Dirt-Bag-Lab-Supplies/dirtbag_switch_box/README.md

# dirtbag_switch_box
RV Electrical Systems
