Dirt-Bag-Lab-Supplies/dirtbag_switch_box/hardware/hardware_calcs.ods

Sheet: Sheet1
Under voltage | 10
Over voltage | 15
Continuous Current | 5.5A
2ms Blanking Time
Cout | 30uF
Output Rise Time | 20 | ms
Current Max | 6 | A
Blanking Time | 2.8 | ms
R1 | 470000
R2 | 39000
R3 | 43000
R2+R3 | e
R2+R3-R2 | #VALUE!
Under voltage
Vuvlo(rising) | 1.2 | V
Vuv | 8.07804878048781
Vuv_test | #VALUE!
Over voltage
Vovlo | 1.2
Vov | 15.4046511627907
Vov_test | #VALUE!
DVDT
Slew Rate | 0.6 | v/ms
Cdvdt | 3333.33333333333 | pF
I limit
Rlim | 555.666666666667 | ohms
Overcurrent Blanking
Ctimer | 3.33774834437086 | nF

Sheet: 5V_Supply
LM22680
https://www.ti.com/lit/ds/symlink/lm22680.pdf?HQS=dis-dk-null-digikeymode-dsf-pf-null-wwe&ts=1633503149819
Vin Max | 15 | V
Vin Min | 7 | V
Vin Test | 42 | V
Vout | 3.3 | V
Iout Max | 2 | A
Iout Min | 0.1 | A
I_test | 2 | A
Fsw | 500 | kHz
Inductor Selection: 8.2.1.2.1
L | (Vin – Vout) * Vout / (0.3 * Iout * Fsw * Vin)
 | 0.010135714285714
Selected L | 0.012 | H
Ripple Current | (Vin – Vout) * Vout /(L * Fsw * Vin)
 | 0.506785714285714
Peak Current | 2.25339285714286
