Dirt-Bag-Lab-Supplies/dirtbag_switch_box/hardware/12v_switch/cad/switchbox_v1.step

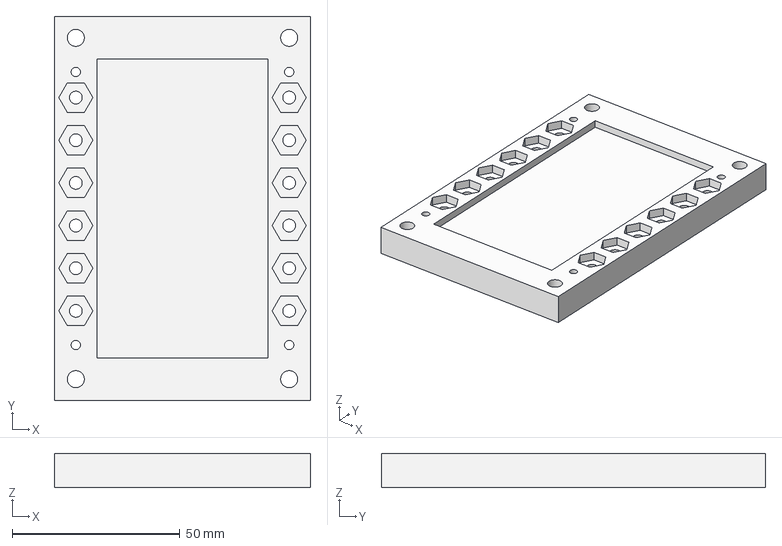
[picture p1: CAD file, 2021-12-15]
hardware/12v_switch/cad/switchbox_v1.step
76.2 x 114.3 x 10.2 mm
LCS_1
