Dirt-Bag-Lab-Supplies/dirtbag_switch_box/hardware/12v_switch/cad/12v_switch_v1.FCStd

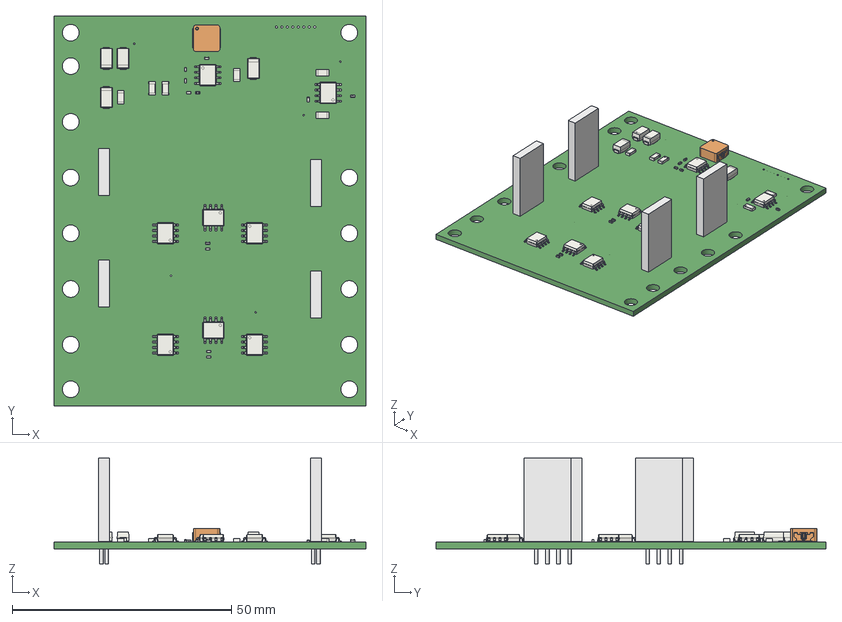
[picture p2: CAD file, 2021-12-15]
hardware/12v_switch/cad/12v_switch_v1.FCStd
71.1 x 88.9 x 24.1 mm
