Dirt-Bag-Lab-Supplies/dirtbag_switch_box/hardware/12v_switch/cad/Nut_Hex_6-32_90480A007.FCStd

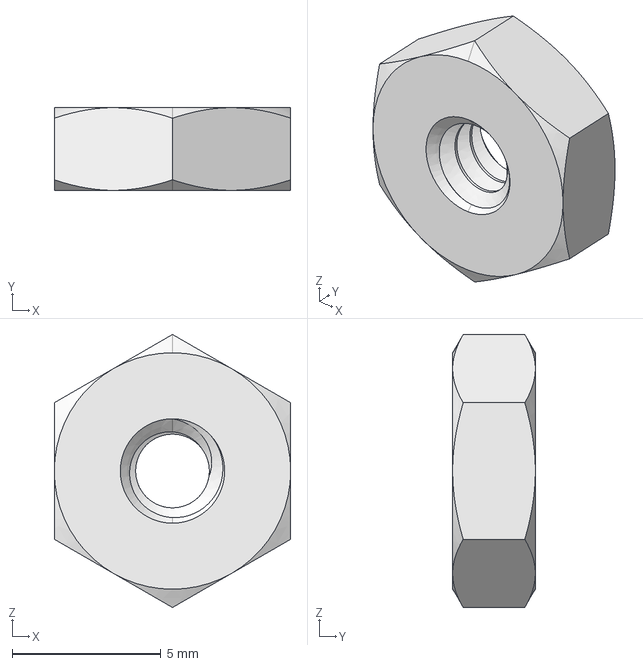
[picture p3: CAD file, 2021-12-15]
hardware/12v_switch/cad/Nut_Hex_6-32_90480A007.FCStd
7.94 x 2.78 x 9.17 mm
