Dirt-Bag-Lab-Supplies/dirtbag_switch_box/(list of files, cad)

Other CAD files:
hardware/12v_switch/cad/12V_switch_Assem.FCStd
hardware/12v_switch/cad/switchbox_v1.FCStd
hardware/12v_switch/cad/switchbox_v1.stl
