Dirt-Bag-Lab-Supplies/dirtbag_switch_box/hardware/12v_switch/cad/12v_switch_pcb.pdf

2.80 "

0.15 "

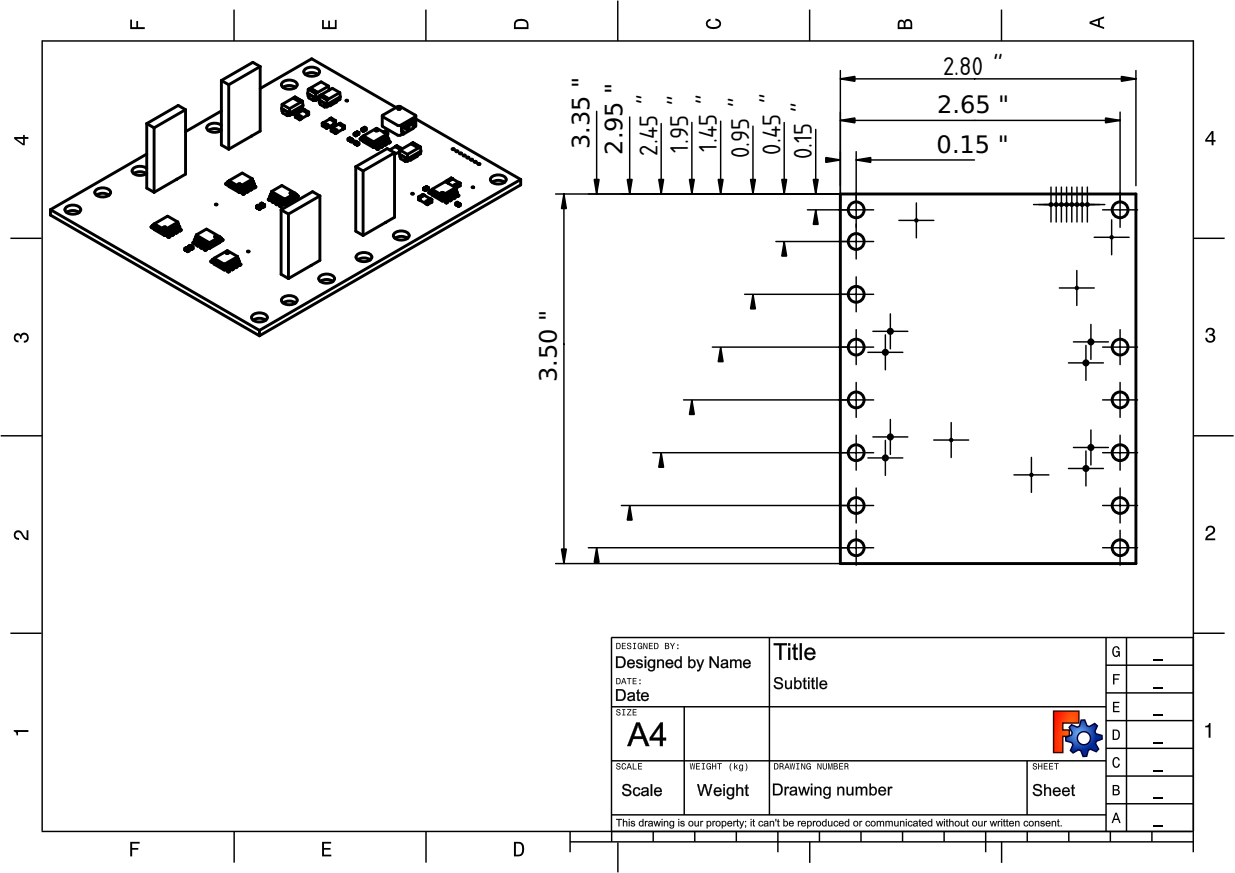
[picture p4: page 1]
