Dirt-Bag-Lab-Supplies/dirtbag_switch_box/hardware/12v_switch/12v_switch.kicad_pcb

## KiCad design hardware/12v_switch/12v_switch.kicad_pcb (2021-12-15)

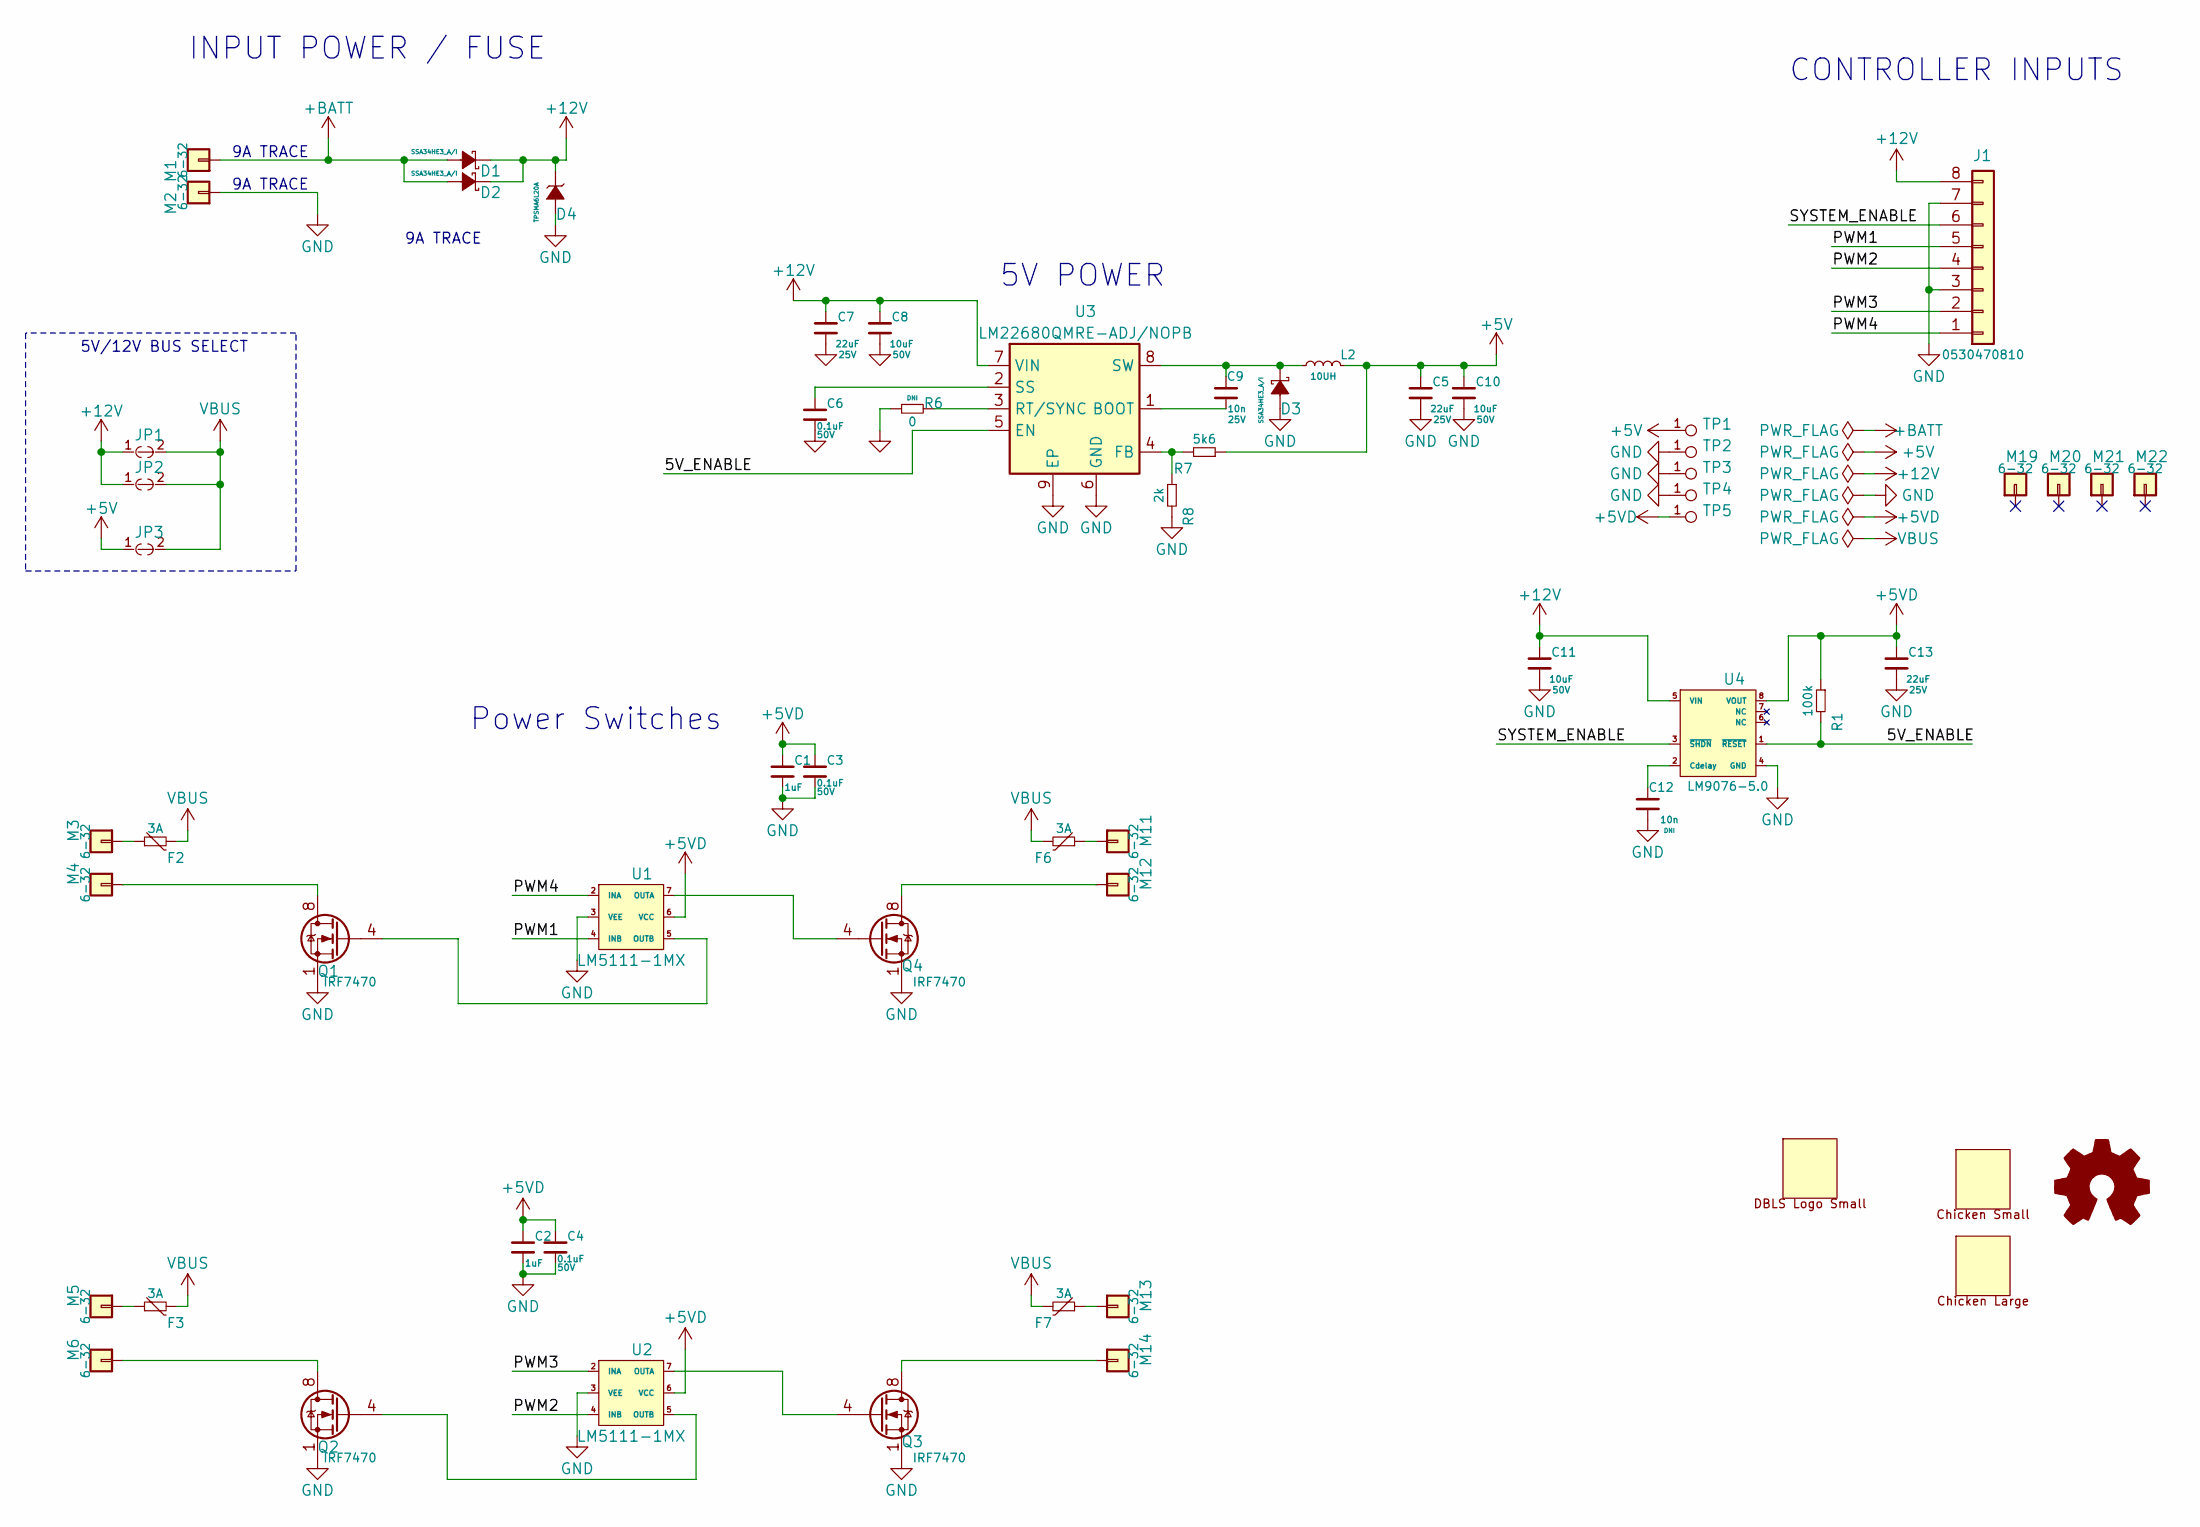
[picture p5: schematic 12v_switch.sch]

Parts:
C1, C2: SMD-CAP-1UF-0402; C_0402_1005Metric; mfg_pn GRM155R61E105KA12D
C3, C4, C6: MURATA_GRM155R71H104ME14J; C_0402; voltage 50V; mfg_pn GRM155R71H104ME14J
C5, C7, C13: MURATA_GRM31CC81E226KE11L; C_1206; voltage 25V; mfg_pn GRM31CC81E226KE11L
C8, C10, C11: MURATA_GRT31CR61H106KE01L; C_1206; voltage 50V; mfg_pn GRT31CR61H106KE01L
C9, C12: MURATA_GCM155R71E103KA37D; C_0402; voltage 25V; mfg_pn GCM155R71E103KA37D
D1, D2, D3: VISHAY_SSA34HE3_A_I; D_SMA; mfg_pn SSA34HE3_A/I
D4: LITTLEFUSE_TPSMA6L20A; D_SMA; mfg_pn TPSMA6L20A
F2, F3, F6, F7: LITTLEFUSE_RGEF300-2; LITTLEFUSE_RGEF; mfg_pn RGEF300-2
J1: MOLEX_0530470810; Molex_PicoBlade_53047-0810_08x1.25mm_Straight; mfg_pn 0530470810
JP1, JP2, JP3: PAD_JUMPER_2PIN_NC
L2: PANASONIC_ETQ-P3M100KVN; L_6.4x6.0_H3; mfg_pn ETQ-P3M100KVN
LOGO1: DBLS_Chicken_Small; Rooster_4mmx4mm
LOGO2: DBLS_Chicken_Large; Rooster_43mmx43mm
LOGO4: DBLS_van_logo_small_v1; van_logo_small
M1, M2, M3, M4, M5, M6, M11, M12, M13, M14: SCREW_6-32_POWER
M19, M20, M21, M22: SCREW_6-32_NORMAL
Q1, Q2, Q3, Q4: INFINEON_IRF7470TRPBF; SOIC-8_3.9x4.9mm_Pitch1.27mm; mfg_pn IRF7470TRPBF
R1: VISHAYDALE_CRCW0402100KJNEDC; R_0402; mfg_pn CRCW0402100KJNEDC
R6: VISHAYDALE_CRCW04020000Z0EDHP; R_0402; mfg_pn CRCW04020000Z0EDHP
R7: VISHAYDALE_CRCW04025K60JNED; R_0402; mfg_pn CRCW04025K60JNED
R8: VISHAYDALE_CRCW04022K00JNEDC; R_0402; mfg_pn CRCW04022K00JNEDC
TP1, TP2, TP3, TP4, TP5: DBLS_TESTPOINT_NORMAL; DBLS_Testpoint_Normal
U1, U2: TI_LM5111-1MX_NOPB; SOIC-8_3.9x4.9mm_Pitch1.27mm; mfg_pn LM5111-1MX/NOPB
U3: TI_LM22680QMRE-ADJ; SOIC-8-1EP_3.9x4.9mm_Pitch1.27mm_ALT; mfg_pn LM22680QMRE-ADJ/NOPB
U4: TI_LM9076BMA-5.0; SOIC-8_3.9x4.9mm_Pitch1.27mm; mfg_pn LM9076BMA-5.0/NOPB

Connections:
+5V: C5.1, C10.1, JP3.1, L2.2, R7.1, TP1.1
+5VD: C1.1, C2.1, C3.1, C4.1, C13.1, R1.1, TP5.1, U1.6 (VCC), U2.6 (VCC), U4.8 (VOUT)
+12V: C7.1, C8.1, C11.1, D1.1 (K), D2.1 (K), D4.1 (K), J1.8, JP1.1, JP2.1, U3.7 (VIN), U4.5 (VIN)
+BATT: D1.2 (A), D2.2 (A), M1.1
/5V_ENABLE: R1.2, U3.5 (EN), U4.1 (~RESET)
/PWM1: J1.5, U1.4 (INB)
/PWM2: J1.4, U2.4 (INB)
/PWM3: J1.2, U2.2 (INA)
/PWM4: J1.1, U1.2 (INA)
/SYSTEM_ENABLE: J1.6, U4.3 (~SHDN)
GND: C1.2, C2.2, C3.2, C4.2, C5.2, C6.2, C7.2, C8.2, C10.2, C11.2, C12.2, C13.2, D3.2 (A), D4.2 (A), J1.3, J1.7, M2.1, Q1.1 (S), Q1.2 (S), Q1.3 (S), Q2.1 (S), Q2.2 (S), Q2.3 (S), Q3.1 (S), Q3.2 (S), Q3.3 (S), Q4.1 (S), Q4.2 (S), Q4.3 (S), R6.1, R8.2, TP2.1, TP3.1, TP4.1, U1.3 (VEE), U2.3 (VEE), U3.6 (GND), U3.9 (EP), U4.4 (GND)
unnamed: C6.1, U3.2 (SS)
unnamed: C9.1, D3.1 (K), L2.1, U3.8 (SW)
unnamed: C9.2, U3.1 (BOOT)
unnamed: C12.1, U4.2 (Cdelay)
unnamed: F2.1, M3.1
unnamed: F3.1, M5.1
unnamed: F6.1, M11.1
unnamed: F7.1, M13.1
unnamed: M4.1, Q1.5 (D), Q1.6 (D), Q1.7 (D), Q1.8 (D)
unnamed: M6.1, Q2.5 (D), Q2.6 (D), Q2.7 (D), Q2.8 (D)
unnamed: M12.1, Q4.5 (D), Q4.6 (D), Q4.7 (D), Q4.8 (D)
unnamed: M14.1, Q3.5 (D), Q3.6 (D), Q3.7 (D), Q3.8 (D)
unnamed: Q1.4 (G), U1.5 (OUTB)
unnamed: Q2.4 (G), U2.5 (OUTB)
unnamed: Q3.4 (G), U2.7 (OUTA)
unnamed: Q4.4 (G), U1.7 (OUTA)
unnamed: R6.2, U3.3 (RT/SYNC)
unnamed: R7.2, R8.1, U3.4 (FB)
VBUS: F2.2, F3.2, F6.2, F7.2, JP1.2, JP2.2, JP3.2

Notes on the sheet:
INPUT POWER / FUSE
9A TRACE
Power Switches
CONTROLLER INPUTS
5V POWER
5V/12V BUS SELECT

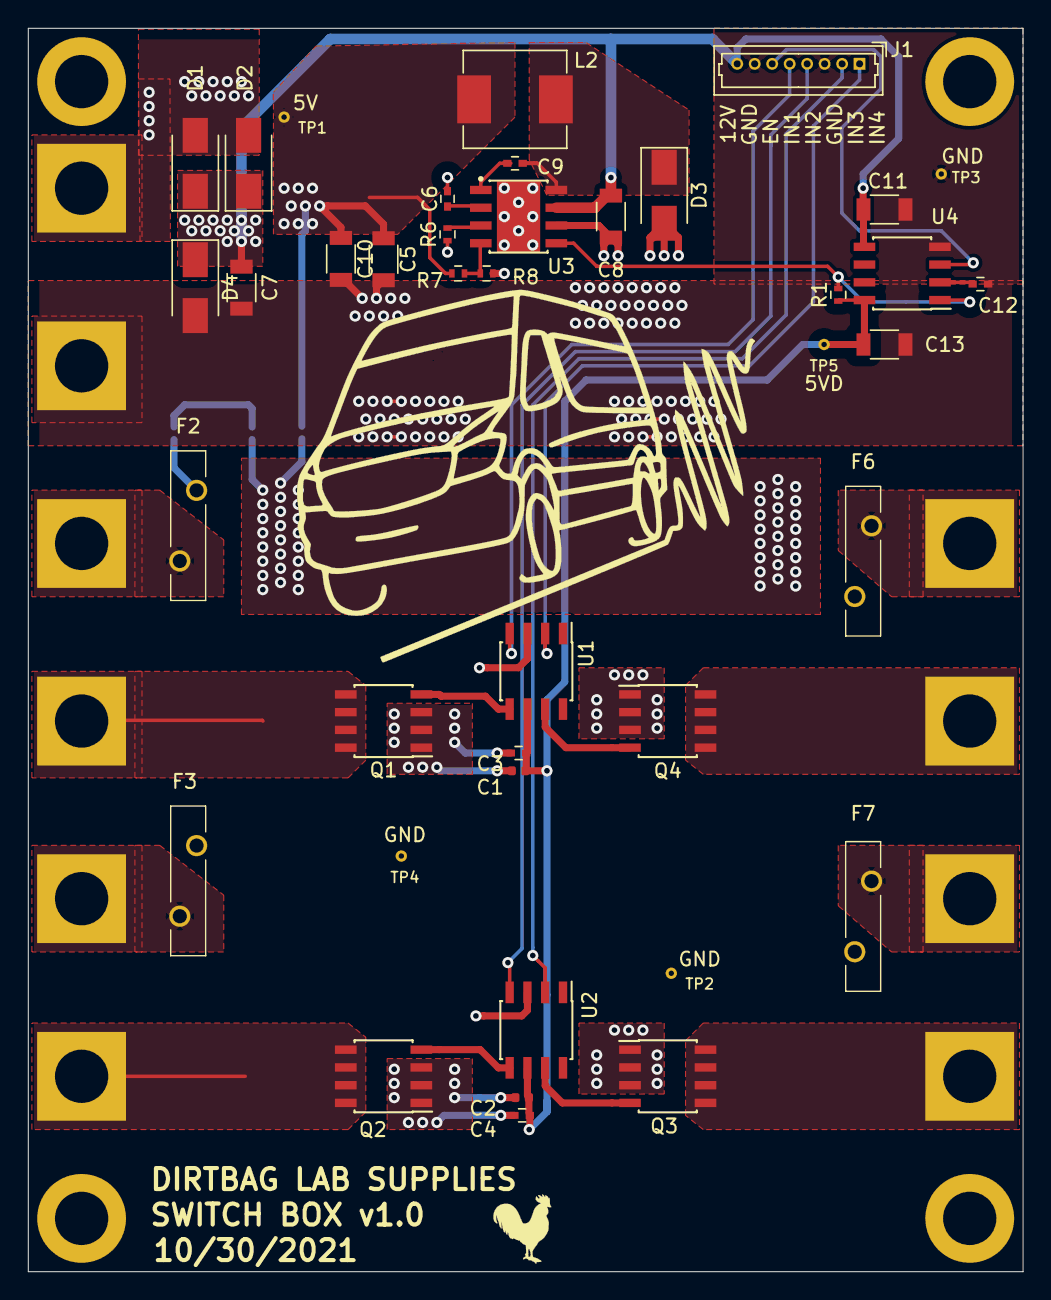
[picture p6: board 12v_switch.kicad_pcb from above]

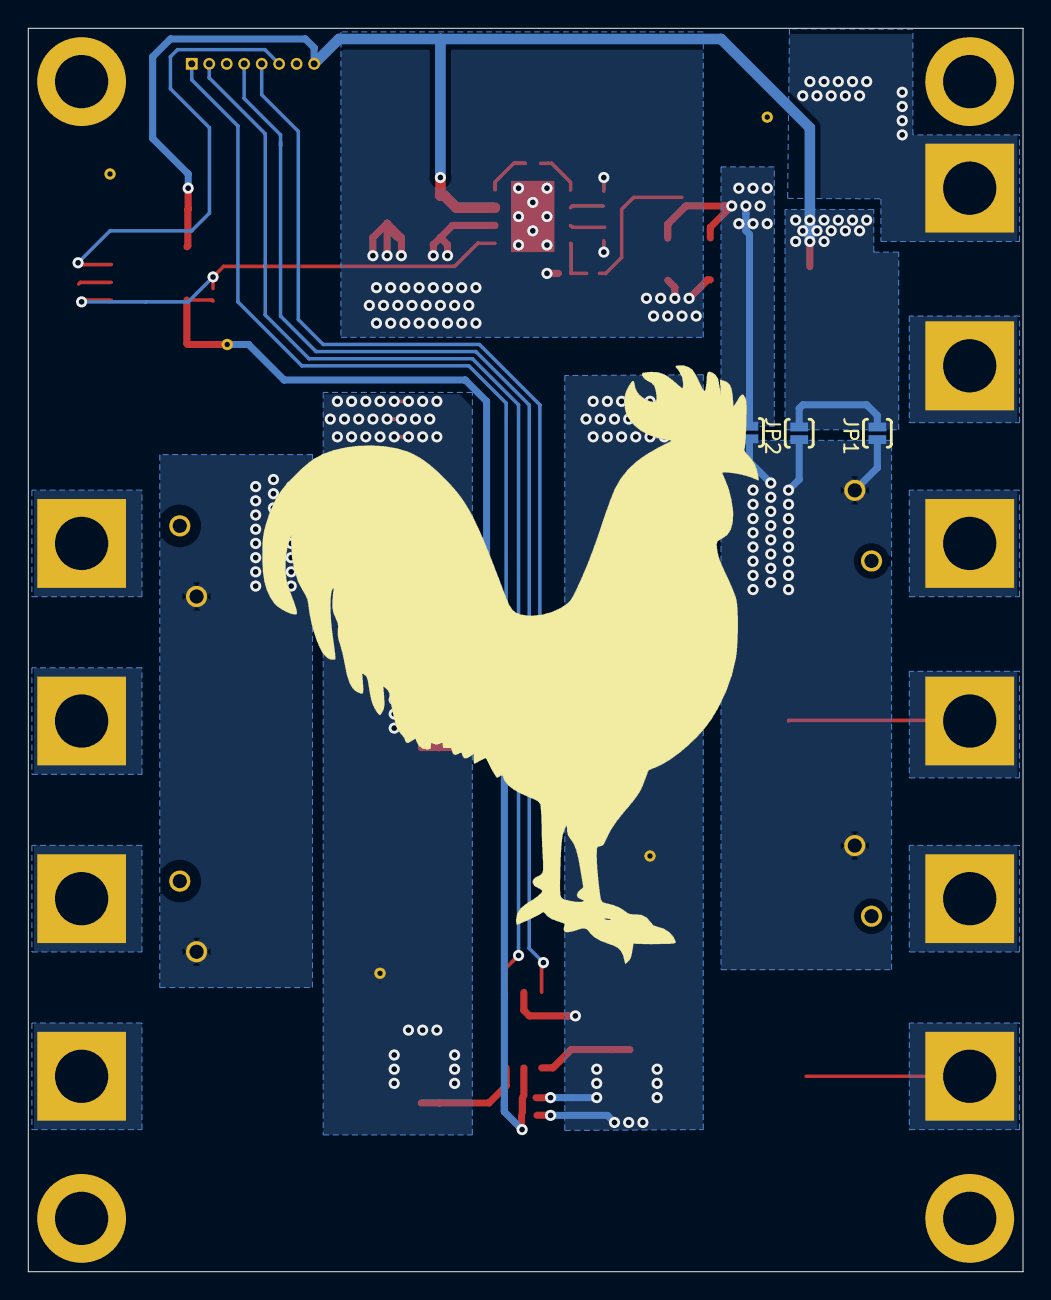
[picture p7: board 12v_switch.kicad_pcb from below]

Board: 2 copper layers, 71.1 x 88.9 mm, 60 parts (4 on the bottom side), 30 nets.
