Dirt-Bag-Lab-Supplies/dirtbag_switch_box/(commit log)

2021-10-17 Added project to git. Uses the Driver modules.
    [12v_switch.kicad_pcb, 12v_switch.sch, hardware_calcs.ods]
2021-10-17 Relayed layout with integrated drivers.
    [12v_switch.kicad_pcb, 12v_switch.sch, Drivers.sch]
2021-10-18 Added fp lib and netlist. Saving before removing mcu.
    [12v_switch.sch]
2021-10-30 First draft layout with 4 switches + buck
    [12v_switch.kicad_pcb, 12v_switch.sch]
2021-10-30 fixed designators. Added logo and labels
    [12v_switch.kicad_pcb, 12v_switch.sch]
2021-10-30 Added interactive BOM.
2021-11-01 added reverse polarity, TVS, and better regulator bypass cap, and fixed feedback resistors
    [12v_switch.kicad_pcb, 12v_switch.sch]
2021-11-01 Added separate 5V gate driver LDO
    [12v_switch.kicad_pcb, 12v_switch.sch]
2021-12-15 added cad files for FreeCAD 0.19
    [12V_switch_Assem.FCStd, 12v_switch.kicad_pcb, 12v_switch.sch, 12v_switch_v1.FCStd, Nut_Hex_6-32_90480A007.FCStd, switchbox_v1.FCStd]
2021-12-15 added step file for switchbox_v1.FCStd1
    [switchbox_v1.step]
2021-12-18 added stl
    [switchbox_v1.stl]
